zchap40/858D-/README.md

# 858E
(Otherwise known as the 858D++)
A new design for a hot air soldering station based on the original 858D+
