zchap40/858D-/PCB/v3.0/Images/858D++_v3.png

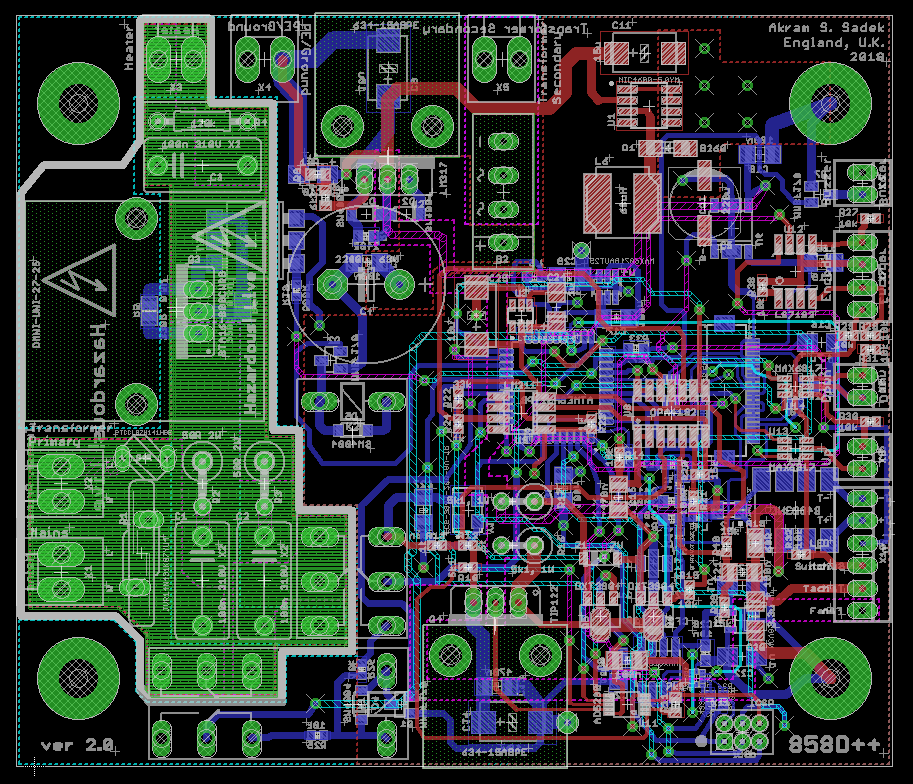
PCB/v3.0/Images/858D++_v3.png
