zchap40/858D-/PCB/v3.0/Images/v3_top.png

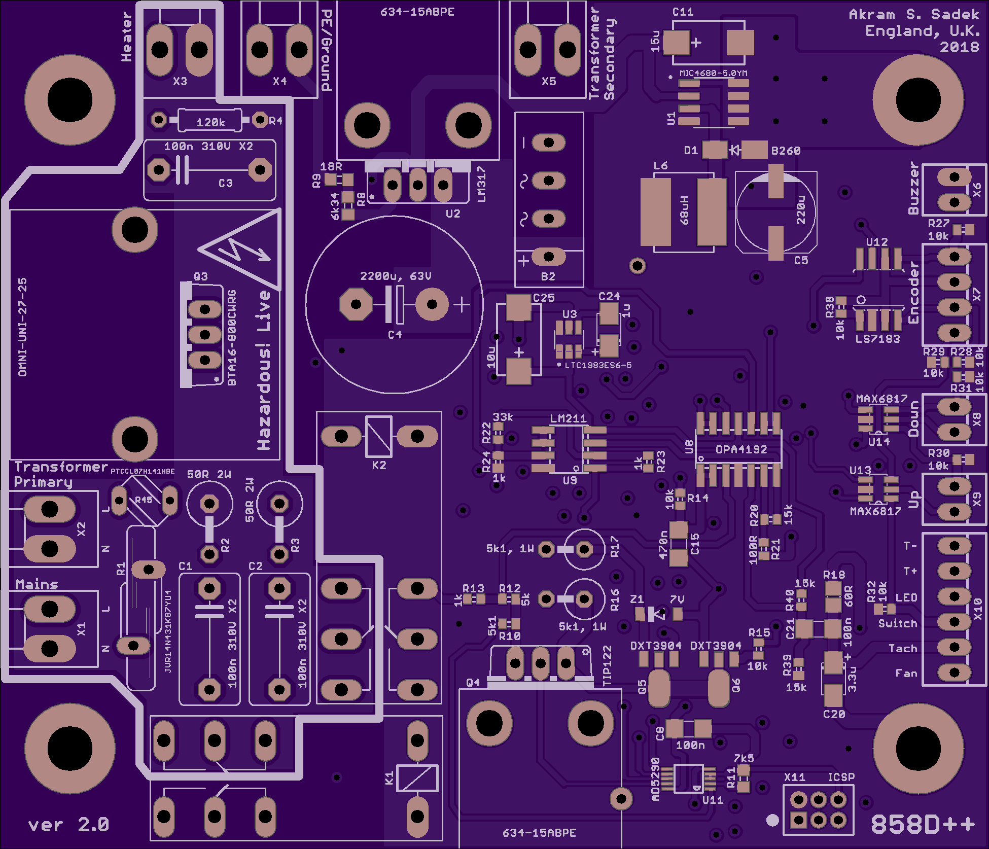
PCB/v3.0/Images/v3_top.png
