zchap40/858D-/BOM/_858D.xlsx

Sheet: ver 1.0
Quantity | Value | Parts | Description | Manufacturer Part Number | Manufacturer | Digi-Key Part Number | Farnell Part Number | Unit Price | Extended Price
1 |  |  | HEATSINK TO-247 TO-264 TO-220 | OMNI-UNI-27-25 | Wakefield-Vette | 345-1567-ND |  | 1.9 | £1.90
3 |  |  | HEATSINK SLIM VERT BLACK TO-220 | 634-15ABPE | Wakefield-Vette | 345-1129-ND |  | 1.41 | £4.23
1 | 24ppr |  | ROTARY ENCODER MECHANICAL 24PPR | PEC16-2215F-S0024 | Bourns Inc. | PEC16-2215F-S0024-ND |  | 1.23 | £1.23
2 | DPDT 8A 5V | K1, K2 | RELAY GENERAL PURPOSE DPDT 8A 5V | G2RL-2 DC5 | Omron Electronics Inc-EMC Div | Z3087-ND |  | 2.81 | £5.62
1 |  | X12 | CONN FFC TOP 24POS 0.50MM R/A | 524352471 | Molex, LLC | WM7975CT-ND |  | 1.91 | £1.91
1 |  |  | CONN MOD JACK 6P6C R/A, RJ-11 | MRJR-3360-01 | Amphenol Commercial Products | MRJR-3360-01-ND |  | 7.9 | £7.90
1 |  |  | CONN HEADER 6POS DL PCB 30GOLD | 69168-106HLF | Amphenol FCI | 609-2423-ND |  | 0.84 | £0.84
1 |  |  | CONN RECPT 6POS 2.54MM CRIMP | 69176-006LF | Amphenol FCI | 609-2380-ND |  | 1.21 | £1.21
6 |  |  | CONN SOCKET 22-26AWG CRIMP GOLD | 75231-013LF | Amphenol FCI | 609-4536-1-ND |  | 0.31 | £1.86
2 | 1000uF | C4, C5 | CAP ALUM 1000UF 20% 63V RADIAL | UHW1J102MHD | Nichicon | 493-14568-ND |  | 1.74 | £3.48
4 | 10uF | C9, C11, C14, C25 | CAP TANTALUM 10UF 63V 2917 | T521X106M063ATE050 | KEMET | 399-10461-1-ND |  | 4.61 | £18.44
1 | 4.7uF | C16 | CAP TANT POLY 4.7UF 35V 1411 | T521B475M035ATE150 | KEMET | 399-14256-1-ND |  | 0.92 | £0.92
1 | 3.3uF | C20 | CAP TANT POLY 3.3UF 35V 1411 |  | KEMET
4 | 1uF | C10, C22, C23, C24 | CAP TANT POLY 1UF 63V 1411 | T521B105M063ATE200 | KEMET | 399-14249-1-ND |  | 1.15 | £2.30
1 | 100nF | C1, C2, C3 | 100n 310V X2
2 | 470nF | C13, C15 | CAP CER 470nF 100V X7R 1206 | CGJ5L2X7R2A474K160AA | TDK Corporation | 445-9231-1-ND |  | 0.99 | £1.98
12 | 100nF |  | CAP CER 100nF 100V C0G 1206 | C3216C0G2A104J160AC | TDK Corporation | 445-172677-1-ND |  | 0.659 | £7.90
1 | 10nF |  | CAP CER 10nF 100V C0G 0603 | C1608C0G2A103J080AC | TDK Corporation | 445-172665-1-ND |  | 0.31 | £0.31
2 | 1uF |  | CAP CER 1uF 16V X7R 1210, X2Y | 160X41W105MV4E | Johanson Dielectrics Inc. | 709-1108-1-ND |  | 0.61 | £1.22
1 | 10nF |  | CAP CER 10nF 50V X7R 0603, X2Y | 500X14W103MV4T | Johanson Dielectrics Inc. | 709-1008-1-ND |  | 0.32 | £0.32
2 | 5k1 |  | RES 5.1K OHM 1W 1% AXIAL | H4P5K1FZA | TE Connectivity Passive Product | A129361-ND |  | 0.67 | £1.34
1 | 330R |  | RES SMD 330 OHM 1% 1/2W 0805 | CRCW0805330RFKEAHP | Vishay Dale | 541-330TCT-ND |  | 0.22 | £0.22
1 | 100R |  | RES 100 OHM 0.5% 1/5W 0402 | MCS0402PD1000DE500 | Vishay Beyschlag | 749-1509-1-ND |  | 0.49 | £0.49
1 | 330R |  | RES SMD 330 OHM 1% 1/5W 0402 | ERJ-PA2F3300X | Panasonic Electronic Components | P17221CT-ND |  | 0.18 | £0.18
1 | 499R |  | RES 499 OHM 0.5% 1/5W 0402 | MCS0402PD4990DE500 | Vishay Beyschlag | 749-1510-1-ND |  | 0.49 | £0.49
3 | 1k |  | RES 1K OHM 0.5% 1/5W 0402 | MCS0402PD1001DE500 | Vishay Beyschlag | 749-1511-1-ND |  | 0.49 | £1.47
1 | 1k69 |  | RES SMD 1.69K OHM 0.1% 1/5W 0603 | ERJ-PB3B1691V | Panasonic Electronic Components | P19996CT-ND |  | 0.2 | £0.20
1 | 240R |  | RES SMD 240 OHM 0.1% 1/5W 0603 | ERJ-PB3B2400V | Panasonic Electronic Components | P19899CT-ND |  | 0.2 | £0.20
1 | 18R |  | RES SMD 18 OHM 1% 1/4W 0603 | ERJ-PA3F18R0V | Panasonic Electronic Components | P18.00BYCT-ND |  | 0.13 | £0.13
1 | 6k34 |  | RES SMD 6.34K OHM 0.1% 1/5W 0603 | ERJ-PB3B6341V | Panasonic Electronic Components | P20064CT-ND |  | 0.2 | £0.20
3 | 4k99 |  | RES 4.99K OHM 0.5% 1/5W 0402 | MCS0402PD4991DE500 | Vishay Beyschlag | 749-1514-1-ND |  | 0.49 | £1.47
1 | 7k5 |  | RES SMD 7.5K OHM 0.1% 1/5W 0603 | ERJ-PB3B7501V | Panasonic Electronic Components | P20072CT-ND |  | 0.2 | £0.20
12 | 10k | R14, R15, R25, R26, R27, R28, R29, R30, R31, R32, R35, R38 | RES 10K OHM 0.5% 1/5W 0402 | MCS0402PD1002DE500 | Vishay Beyschlag | 749-1515-1-ND |  | 0.381 | £4.57
3 | 15k |  | RES 15K OHM 0.5% 1/5W 0402 | MCS0402PD1502DE500 | Vishay Beyschlag | 749-1516-1-ND |  | 0.49 | £1.47
1 | 33k |  | RES SMD 33K OHM 1% 1/5W 0402 | ERJ-PA2F3302X | Panasonic Electronic Components | P17233CT-ND |  | 0.18 | £0.18
1 | 412k |  | RES SMD 412K OHM 1% 1/10W 0603 | ERJ-3EKF4123V | Panasonic Electronic Components | P412KHCT-ND |  | 0.08 | £0.08
1 | 59R |  | RES SMD 59 OHM 1% 1/2W 0805 | ERJ-P06F59R0V | Panasonic Electronic Components | P16075CT-ND |  | 0.16 | £0.16
2 | 300R |  | RES SMD 300 OHM 0.1% 1/5W 0603 | ERJ-PB3B3000V | Panasonic Electronic Components | P19910CT-ND |  | 0.2 | £0.40
2 | 1M |  | RES SMD 1M OHM 1% 1/5W 0402 | ERJ-PA2F1004X | Panasonic Electronic Components | P17242CT-ND |  | 0.18 | £0.36
1 |  |  | CMC 260MA 2LN 600 OHM SMD | DLW31SN601SQ2L | Murata Electronics North America | 490-1068-1-ND |  | 0.96 | £0.96
2 |  |  | FERRITE BEAD 1 KOHM 0402 1LN | BLM15AX102SZ1D | Murata Electronics North America | 490-16654-1-ND |  | 0.09 | £0.18
1 | B4003 |  | COMMON MODE CHOKE 2LN SMD | B4003NLT | Pulse Electronics Network | 553-2143-1-ND |  | 3.19 | £3.19
1 | 10uH |  | INDUCTORPWR IND FOR DC/DC CONVER | L0603B100MDWFT | KEMET | 399-17788-1-ND |  | 0.32 | £0.32
2 | KBP310 |  | BRIDGE RECT 1PHASE 1KV 3A KBP | KBP310GTB | SMC Diode Solutions | 1655-1832-ND |  | 0.37 | £0.74
5 | SM4004 |  | DIODE GEN PURP 400V 1A SOD123FL | SM4004PL-TP | Micro Commercial Co | SM4004PL-TPMSCT-ND |  | 0.42 | £2.10
1 | PLZ7V5 |  | DIODE ZENER 7.035V 960MW DO219AC | PLZ7V5A-HG3/H | Vishay Semiconductor Diodes Division | PLZ7V5A-HG3/HGICT-ND |  | 0.26 | £0.26
3 | MMBF170 |  | MOSFET N-CH 60V 500MA SOT-23 | MMBF170LT1G | ON Semiconductor | MMBF170LT1GOSCT-ND |  | 0.28 | £0.84
2 | DXT3904 |  | TRANS NPN 40V 0.2A SOT89-3 | DXT3904-13 | Diodes Incorporated | DXT3904-13DICT-ND |  | 0.42 | £0.84
1 | TIP122 |  | TRANS NPN DARL 100V 5A TO220AB | TIP122G | ON Semiconductor | TIP122GOS-ND |  | 0.52 | £0.52
1 | BTA16-800 |  | TRIAC ALTERNISTOR 800V TO220AB | BTA16-800CWRG | STMicroelectronics | 497-4166-5-ND |  | 1.31 | £1.31
1 | LD1085V50 |  | IC REG LINEAR 5V 3A TO220AB | LD1085V50 | STMicroelectronics | 497-3436-5-ND |  | 1.02 | £1.02
1 | LM317 |  | IC REG LINEAR POS ADJ TO220-3 | LM317HVT/NOPB | Texas Instruments | LM317HVT/NOPB-ND |  | 1.93 | £1.93
1 | NCV8161-3.3V |  | IC REG LINEAR 3.3V 450MA 5TSOP | NCV8161ASN330T1G | ON Semiconductor | NCV8161ASN330T1GOSCT-ND |  | 0.45 | £0.45
1 | S1142-12.5V |  | IC REG LINEAR 12.5V 200MA 6HSOP | S-1142CC5I-E6T1U | ABLIC U.S.A. Inc. | 1662-2477-1-ND |  | 1.28 | £1.28
1 | LTC1983-5V |  | IC REG SWTCHD CAP INV -5V SOT23 | LTC1983ES6-5#TRPBF | Linear Technology/Analog Devices | LTC1983ES6-5#TRPBFCT-ND |  | 3.33 | £3.33
1 | ATMEGA324PB |  | IC MCU 8BIT 32KB FLASH 44TQFP | ATMEGA324PB-AN | Microchip Technology | ATMEGA324PB-AN-ND |  | 1.47 | £1.47
1 | LS7183 |  | Encoder to Counter Interface | LS7183N-S | LSI Computer Systems
1 | MAX31855 |  | IC CONV THERMOCOUPLE-DGTL SOIC | MAX31855KASA | Maxim Integrated | MAX31855KASA+-ND |  | 3.52
1 | AD5290 |  | DIGITAL POT 10K 256POS 10MSOP | AD5290YRMZ10 | Analog Devices | AD5290YRMZ10-ND |  | 4.3
2 | MAX6817 |  | IC DEBOUNCER SWITCH DUAL SOT23-6 | MAX6817EUT+T | Maxim Integrated | MAX6817EUT+TCT-ND |  | 4.1 | £8.20
1 | LM211 |  | IC DIFF COMPARATOR W/STRB 8-SOIC | LM211QDRQ1 | Texas Instruments | 296-17493-1-ND |  | 0.59 | £0.59
1 | OPA4192 | U8 | IC OPAMP RRI/O 14SOIC | OPA4192IDR | Texas Instruments | 296-43159-1-ND |  | 5.18 | £5.18
1 | MOC3062 |  | OPTOISOLATOR 4.17KV TRIAC 6SMD | MOC3062SR2VM | ON Semiconductor | MOC3062SR2VMCT-ND |  | 1.25 | £1.25
1 | 20.0000MHz | Y1 | XTAL OSC XO 20.0000MHZ HCMOS SMD | ECS-3961-200-AU-TR | ECS Inc. | XC1900CT-ND |  | 1.83 | £1.83

Sheet: ver 2.0
Qty | Value | Device | Package | Parts | Description | AVAILABILITY | DESCRIPTION | DIGI-KEY_PART_NUMBER | DIGI-KEY_PURCHASE_URL | MF | MP | MPN | OC_FARNELL | OC_NEWARK | PACKAGE | PRICE
3 | 22-23-2021 | 22-23-2021 | 22-23-2021 | X8, X9, X11 | .100 (2.54mm) Center Header - 2 Pin" |  |  |  |  | MOLEX |  | 22-23-2021 | 1462926 | 25C3832
1 | 22-23-2041 | 22-23-2041 | 22-23-2041 | X7 | .100 (2.54mm) Center Header - 4 Pin" |  |  |  |  | MOLEX |  | 22-23-2041 | 1462920 | 38C0355
1 |  | 22-23-2061 | 22-23-2061 | X10 | .100 (2.54mm) Center Header - 6 Pin" |  |  |  |  | MOLEX |  | 22-23-2061 | 1462922 | 27C1933
4 |  | KK-156-2 | KK-156-2 | X1, X2, X3, X4 | KK 156 HEADER |  |  |  |  |  |  |  | unknown | unknown
1 |  | KK-156-4 | KK-156-4 | X5 | KK 156 HEADER |  |  |  |  |  |  |  | unknown | unknown
2 | 1000uF, 63V | CPOL-EUE5-13 | E5-13 | C4, C5 | POLARIZED CAPACITOR, European symbol
4 | 10u | CPOL-USCT7343 | CT7343 | C9, C11, C14, C25 | POLARIZED CAPACITOR, American symbol
1 | 4.7u | CPOL-USB/3528-21W | B/3528-21W | C16 | POLARIZED CAPACITOR, American symbol
1 | 3.3u | CPOL-USB/3528-21W | B/3528-21W | C20 | POLARIZED CAPACITOR, American symbol
4 | 1u | CPOL-USB/3528-21W | B/3528-21W | C10, C22, C23, C24 | POLARIZED CAPACITOR, American symbol
2 | 470n | C-EUC1206 | C1206 | C13, C15 | CAPACITOR, European symbol
3 | 100n 310V X2 | C10/6 | C10B6 | C1, C2, C3 | CAPACITOR
12 | 100n | C-EUC1206 | C1206 | C6, C7, C8, C12, C17, C18, C19, C21, C26, C27, C29, C30 | CAPACITOR, European symbol
1 | 10n | C-EUC0603 | C0603 | C28 | CAPACITOR, European symbol
2 | 1u | X2Y1206 | C1206-X2Y | CF1, CF2
1 | 10n | X2Y0603 | C0603-X2Y | CF3
1 | 10uH | KLZ1608MHR100WTD25 | INDC1608X95N | L5 | FIXED IND 10UH 250MA 1.365 OHM | Unavailable | Inductor Decoupling Circuit Shielded Multi-Layer 10uH 20% 2MHz Ferrite 250mA 1.365Ohm DCR 0603 Automotive T/R |  |  | TDK | KLZ1608MHR100WTD25 |  |  |  | 0603 TDK | None
1 | B4003NL | B4003NL | SMD-VERTICAL | L1 | Pulse Electronics
2 | BLM15AX102SZ1D | BLM15HB121SN1 | 402 | L3, L4 | EMIFIL (R) Chip Ferrite Bead for GHz Noise
1 | DLW31SN601SQ2L | DLW31SN900SQ2L | FIL_DLW31SN900SQ2L | L2 | Common Mode Chokes Dual 90Ohm 100MHz 370mA 300mOhm DCR SMD Embossed T/R |  | Common Mode Chokes Dual 90Ohm 100MHz 370mA 300mOhm DCR SMD Embossed T/R | 490-1067-1-ND | https://www.digikey.com/product-detail/en/murata-electronics-north-america/DLW31SN900SQ2L/490-1067-1-ND/584513 | Murata Electronics | DLW31SN900SQ2L |  |  |  | Horizontal-4 Murata Electronics
1 | 100R | R-EU_R0402 | R0402 | R21 | RESISTOR, European symbol
1 | 120k | R-EU_0207/10 | 0207/10 | R4 | RESISTOR, European symbol
12 | 10k | R-EU_R0402 | R0402 | R14, R15, R25, R26, R27, R28, R29, R30, R31, R32, R35, R38 | RESISTOR, European symbol
3 | 15k | R-EU_R0402 | R0402 | R20, R39, R40 | RESISTOR, European symbol
1 | 18R | R-EU_R0603 | R0603 | R9 | RESISTOR, European symbol
2 | 1M | R-EU_R0402 | R0402 | R43, R44 | RESISTOR, European symbol
3 | 1k | R-EU_R0402 | R0402 | R13, R23, R24 | RESISTOR, European symbol
1 | 1k7 | R-EU_R0603 | R0603 | R33 | RESISTOR, European symbol
1 | 240R | R-EU_R0603 | R0603 | R7 | RESISTOR, European symbol
2 | 300R, 0.1% | R-EU_R0603 | R0603 | R41, R42 | RESISTOR, European symbol
2 | 330R | R-EU_R0402 | R0402 | R36, R37 | RESISTOR, European symbol
2 | 330R, 0.5W | R-EU_R0805 | R0805 | R5, R6 | RESISTOR, European symbol
1 | 33k | R-EU_R0402 | R0402 | R22 | RESISTOR, European symbol
1 | 412k | R-EU_R0603 | R0603 | R34 | RESISTOR, European symbol
1 | 500R | R-EU_R0402 | R0402 | R19 | RESISTOR, European symbol
2 | 50R 2W | R-EU_0613/5V | P0613V | R2, R3 | RESISTOR, European symbol
1 | 5k | R-EU_R0402 | R0402 | R12 | RESISTOR, European symbol
1 | 5k1 | R-EU_R0402 | R0402 | R10 | RESISTOR, European symbol
2 | 5k1, 1W | R-EU_0411/3V | 0411V | R16, R17 | RESISTOR, European symbol
1 | 60R | R-EU_R0805 | R0805 | R18 | RESISTOR, European symbol
1 | 6k34 | R-EU_R0603 | R0603 | R8 | RESISTOR, European symbol
1 | 7V | ZENER-DIODEDO-219AC | MICROSMF | Z1 | Z-Diode
1 | 7k5 | R-EU_R0603 | R0603 | R11 | RESISTOR, European symbol
1 | 87758-06_S | 87758-06_S | 87758-06 | X12 | HEADER
1 | AD5290 | AD5290 | MSOP10 | U11 | Compact +30 V / ±15 V 256-Position Digital Potentiometer
1 | ATMEGA324PB | ATMEGA324PB-ANR | QFP80P1200X1200X120-44N | U15 | None | Unavailable | 20mhz, Tqfp, Extended Temp, Green 5 v t&r |  |  | Microchip | ATMEGA324PB-ANR |  |  |  | TQFP-44 Microchip | None
1 | BTA16-800CWRG | BT138-V | TO220BV | Q3 | TRIAC
2 | DXT3904 | DXT3904 | SOT89-BCE | Q5, Q6 | Diodes Incorporated
1 | ECS-3961-200-AU-TR | ECS-3961-200-AU-TR | OSC_ECS-3961-200-AU-TR | Y1 | miniature SMD crystal controlled oscillators |  | Clock Oscillator 20MHz 5V 30pF 4-Pin SMD T/R | XC1900CT-ND | https://www.digikey.co.uk/product-detail/en/ecs-inc/ECS-3961-200-AU-TR/XC1900CT-ND/2782025 | ECS Inc. | ECS-3961-200-AU-TR |  |  |  | SMD-4 ECS International
1 | FH12-24S-0.5SH | FH12-24S-0.5SH | FH12-24S-0.5SH | X6 | 0.5mm Pitch Connectors For FPC/FFC |  |  |  |  |  |  | FH12-24S-0.5SH(55) | 1324552 | 34M6170
1 | JVR14N431K87YU4 | S14K11 | S14K11 | R1 | VARISTOR
2 | KBP310GTB | RECTIFIER-2KBP | 2KBP | B1, B2 | Rectifier
1 | LD1085V50 | 7805TV | TO220V | U1 | Positive VOLTAGE REGULATOR
1 | LM211 | LM311D | SO08 | U9 | COMPARATOR
1 | LM317 | LM317TS | 317TS | U2 | VOLTAGE REGULATOR
1 | LS7183 | LS7183-SOIC | SOIC08 | U12 | Encoder to Counter Interface | Unavailable | Semi-Linear-Cmos Power Source |  |  | LSI | LS7183 |  |  |  | None | None
1 | LTC1983ES6-5 | LTC1983ES6-5#TRPBF | SOT95P280X100-6N | U3 | Charge Pump INV -5V/-2.3V to -5.5V 100mA 6-Pin TSOT-23 T/R |  | Charge Pump INV -5V/-2.3V to -5.5V 100mA 6-Pin TSOT-23 T/R | LTC1983ES6-5#TRPBFCT-ND | https://www.digikey.co.uk/product-detail/en/linear-technology-analog-devices/LTC1983ES6-5-TRPBF/LTC1983ES6-5-TRPBFCT-ND/7897923 | Linear Technology/Analog | LTC1983ES6-5#TRPBF |  |  |  | SOT-23-6 Analog Devices / Linear Technology
1 | MAX31855 | MAX31855 | SOIC127P600X175-8N | U7 | Cold-Junction Compensated Thermocouple-to-Digital Converter | Unavailable |  |  |  | Maxim Integrated | MAX31855 |  |  |  | SO-8 Maxim Integrated | None
1 | MAX6071BAUT25T | MAX6071BAUT25T | 21-0058I | U4 |  |  | V-Ref Precision 2.5V 10mA 6-Pin SOT-23 T/R | MAX6071BAUT25+TCT-ND | https://www.digikey.co.uk/product-detail/en/maxim-integrated/MAX6071BAUT25-T/MAX6071BAUT25-TCT-ND/5051522 | Maxim Integrated | MAX6071BAUT25+T |  |  |  | SOT-23-6 Maxim Integrated
2 | MAX6817 | MAX6817EUT+T | SOT95P280X145-6N | U13, U14 | ±15kV ESD-Protected CMOS Switch Debouncers |  | Ic Debouncer Switch Dual Sot23-6 - Max6817eut+t | MAX6817EUT+TCT-ND | https://www.digikey.co.uk/product-detail/en/maxim-integrated/MAX6817EUT-T/MAX6817EUT-TCT-ND/774156 | Maxim Integrated | MAX6817EUT+T |  |  |  | SOT-23-6 Maxim Integrated
3 | MMBF170 | MMBF170LT1G | SOT23 | Q1, Q2, Q7 | Power MOSFET
1 | MOC3062SR2VM | MOC3041S | DIL6-SMD | U10 | 6-Pin DIP Zero-Cross Optoisolators Triac Driver Output (250/400 Volt Peak) |  |  |  |  | FAIRCHILD SEMICONDUCTOR |  | MOC3041S-M | unknown | 05C2885
1 | NCV8161-3.3V | NCV8161ASN330T1G | SOT23-DBV | U5 | ON Semiconductor
1 | OPA4192 | OP11D | SO14 | U8 | Quad Low-Offset Low-Power OP AMP
1 | S-1142DC5I | S-1142CC5I-E6T1U | HSOP-6 | U6 | HIGH-WITHSTAND VOLTAGE LOW CURRENT CONSUMPTION LOW DROPOUT
5 | SM4004 | SM4004 | SOD123FL | D1, D2, D3, D4, D5 | 1.0 Ampere Silion Rectifier 400V SMD
1 | TIP122 | TIP122-V | TO220V | Q4
2 | 4052 | 4052 | F4052 | K1, K2 | RELAY |  |  |  |  |  |  |  | unknown | unknown
3 | 634-15ABPE | 634-15ABPE | 634-15ABPE | HS1, HS2, HS4 | Wakefield-Vette 634-15-ABPE
1 | OMNI-UNI-27-25 | OMNI-UNI-27-25 | OMNI-UNI-27-25 | HS3

Sheet: Bom_7735623
Manufacturer Part Number | Manufacturer | Digi-Key Part Number | Customer Reference | Quantity | Unit Price | Extended Price | Description
OMNI-UNI-27-25 | Wakefield-Vette | 345-1567-ND |  | 1 | 1.9 | £1.90 | HEATSINK TO-247 TO-264 TO-220
G2RL-2 DC5 | Omron Electronics Inc-EMC Div | Z3087-ND |  | 2 | 2.81 | £5.62 | RELAY GENERAL PURPOSE DPDT 8A 5V
524352471 | Molex, LLC | WM7975CT-ND |  | 1 | 1.91 | £1.91 | CONN FFC TOP 24POS 0.50MM R/A
KBP310GTB | SMC Diode Solutions | 1655-1832-ND |  | 2 | 0.37 | £0.74 | BRIDGE RECT 1PHASE 1KV 3A KBP
S-1142CC5I-E6T1U | ABLIC U.S.A. Inc. | 1662-2477-1-ND |  | 1 | 1.28 | £1.28 | IC REG LINEAR 12.5V 200MA 6HSOP
LTC1983ES6-5#TRPBF | Linear Technology/Analog Devices | LTC1983ES6-5#TRPBFCT-ND |  | 1 | 3.33 | £3.33 | IC REG SWTCHD CAP INV -5V SOT23
SM4004PL-TP | Micro Commercial Co | SM4004PL-TPMSCT-ND |  | 4 | 0.42 | £1.68 | DIODE GEN PURP 400V 1A SOD123FL
MMBF170LT1G | ON Semiconductor | MMBF170LT1GOSCT-ND |  | 3 | 0.28 | £0.84 | MOSFET N-CH 60V 500MA SOT-23
634-15ABPE | Wakefield-Vette | 345-1129-ND |  | 2 | 1.41 | £2.82 | HEATSINK SLIM VERT BLACK TO-220
DXT3904-13 | Diodes Incorporated | DXT3904-13DICT-ND |  | 2 | 0.42 | £0.84 | TRANS NPN 40V 0.2A SOT89-3
LM317HVT/NOPB | Texas Instruments | LM317HVT/NOPB-ND |  | 1 | 1.93 | £1.93 | IC REG LINEAR POS ADJ TO220-3
T521X106M063ATE050 | KEMET | 399-10461-1-ND |  | 3 | 4.61 | £13.83 | CAP TANTALUM 10UF 63V 2917
T521B105M063ATE200 | KEMET | 399-14249-1-ND |  | 4 | 1.15 | £4.60 | CAP TANT POLY 1UF 63V 1411
CGJ5L2X7R2A474K160AA | TDK Corporation | 445-9231-1-ND |  | 2 | 0.99 | £1.98 | CAP CER 0.47UF 100V X7R 1206
PLZ7V5A-HG3/H | Vishay Semiconductor Diodes Division | PLZ7V5A-HG3/HGICT-ND |  | 1 | 0.26 | £0.26 | DIODE ZENER 7.035V 960MW DO219AC
H4P5K1FZA | TE Connectivity Passive Product | A129361-ND |  | 2 | 0.67 | £1.34 | RES 5.1K OHM 1W 1% AXIAL
PEC16-2215F-S0024 | Bourns Inc. | PEC16-2215F-S0024-ND |  | 1 | 1.23 | £1.23 | ROTARY ENCODER MECHANICAL 24PPR
NCV8161ASN330T1G | ON Semiconductor | NCV8161ASN330T1GOSCT-ND |  | 1 | 0.45 | £0.45 | IC REG LINEAR 3.3V 450MA 5TSOP
ATMEGA324PB-AN | Microchip Technology | ATMEGA324PB-AN-ND |  | 1 | 1.47 | £1.47 | IC MCU 8BIT 32KB FLASH 44TQFP
LM211QDRQ1 | Texas Instruments | 296-17493-1-ND |  | 1 | 0.59 | £0.59 | IC DIFF COMPARATOR W/STRB 8-SOIC
ECS-3961-200-AU-TR | ECS Inc. | XC1900CT-ND |  | 1 | 1.83 | £1.83 | XTAL OSC XO 20.0000MHZ HCMOS SMD
MAX6817EUT+T | Maxim Integrated | MAX6817EUT+TCT-ND |  | 2 | 4.1 | £8.20 | IC DEBOUNCER SWITCH DUAL SOT23-6
TIP122G | ON Semiconductor | TIP122GOS-ND |  | 1 | 0.52 | £0.52 | TRANS NPN DARL 100V 5A TO220AB
T521B475M035ATE150 | KEMET | 399-14256-1-ND |  | 1 | 0.92 | £0.92 | CAP TANT POLY 4.7UF 35V 1411
MRJR-3360-01 | Amphenol ICC (Commercial Products) | MRJR-3360-01-ND |  | 1 | 7.9 | £7.90 | CONN MOD JACK 6P6C R/A
69168-106HLF | Amphenol ICC (FCI) | 609-2423-ND |  | 1 | 0.84 | £0.84 | CONN HEADER VERT 6POS 2.54MM
75231-013LF | Amphenol ICC (FCI) | 609-4536-1-ND |  | 6 | 0.31 | £1.86 | CONN SOCKET 22-26AWG CRIMP GOLD
69176-006LF | Amphenol ICC (FCI) | 609-2380-ND |  | 1 | 1.21 | £1.21 | CONN RECPT 6POS 2.54MM CRIMP
MOC3062SR2VM | ON Semiconductor | MOC3062SR2VMCT-ND |  | 1 | 1.25 | £1.25 | OPTOISOLATOR 4.17KV TRIAC 6SMD
BTA16-800CWRG | STMicroelectronics | 497-4166-5-ND |  | 1 | 1.31 | £1.31 | TRIAC ALTERNISTOR 800V TO220AB
OPA4192IDR | Texas Instruments | 296-43159-1-ND |  | 1 | 5.18 | £5.18 | IC OPAMP RRI/O 14SOIC
CRCW0805330RFKEAHP | Vishay Dale | 541-330TCT-ND |  | 1 | 0.22 | £0.22 | RES SMD 330 OHM 1% 1/2W 0805
MCS0402PD1000DE500 | Vishay Beyschlag | 749-1509-1-ND |  | 1 | 0.49 | £0.49 | RES 100 OHM 0.5% 1/5W 0402
ERJ-PA2F3300X | Panasonic Electronic Components | P17221CT-ND |  | 1 | 0.18 | £0.18 | RES SMD 330 OHM 1% 1/5W 0402
MCS0402PD4990DE500 | Vishay Beyschlag | 749-1510-1-ND |  | 1 | 0.49 | £0.49 | RES 499 OHM 0.5% 1/5W 0402
MCS0402PD1001DE500 | Vishay Beyschlag | 749-1511-1-ND |  | 3 | 0.49 | £1.47 | RES 1K OHM 0.5% 1/5W 0402
ERJ-PB3B1691V | Panasonic Electronic Components | P19996CT-ND |  | 1 | 0.2 | £0.20 | RES SMD 1.69K OHM 0.1% 1/5W 0603
ERJ-PB3B2400V | Panasonic Electronic Components | P19899CT-ND |  | 1 | 0.2 | £0.20 | RES SMD 240 OHM 0.1% 1/5W 0603
ERJ-PA3F18R0V | Panasonic Electronic Components | P18.00BYCT-ND |  | 1 | 0.13 | £0.13 | RES SMD 18 OHM 1% 1/4W 0603
ERJ-PB3B6341V | Panasonic Electronic Components | P20064CT-ND |  | 1 | 0.2 | £0.20 | RES SMD 6.34K OHM 0.1% 1/5W 0603
MCS0402PD4991DE500 | Vishay Beyschlag | 749-1514-1-ND |  | 3 | 0.49 | £1.47 | RES 4.99K OHM 0.5% 1/5W 0402
ERJ-PB3B7501V | Panasonic Electronic Components | P20072CT-ND |  | 1 | 0.2 | £0.20 | RES SMD 7.5K OHM 0.1% 1/5W 0603
MCS0402PD1002DE500 | Vishay Beyschlag | 749-1515-1-ND |  | 20 | 0.381 | £7.62 | RES 10K OHM 0.5% 1/5W 0402
MCS0402PD1502DE500 | Vishay Beyschlag | 749-1516-1-ND |  | 3 | 0.49 | £1.47 | RES 15K OHM 0.5% 1/5W 0402
ERJ-PA2F3302X | Panasonic Electronic Components | P17233CT-ND |  | 1 | 0.18 | £0.18 | RES SMD 33K OHM 1% 1/5W 0402
ERJ-3EKF4123V | Panasonic Electronic Components | P412KHCT-ND |  | 1 | 0.08 | £0.08 | RES SMD 412K OHM 1% 1/10W 0603
ERJ-P06F59R0V | Panasonic Electronic Components | P16075CT-ND |  | 1 | 0.16 | £0.16 | RES SMD 59 OHM 1% 1/2W 0805
500X14W103MV4T | Johanson Dielectrics Inc. | 709-1008-1-ND |  | 1 | 0.32 | £0.32 | CAP CER 10000PF 50V X7R 0603
160X41W105MV4E | Johanson Dielectrics Inc. | 709-1108-1-ND |  | 2 | 0.61 | £1.22 | CAP CER 1UF 16V X7R 1210
DLW31SN601SQ2L | Murata Electronics North America | 490-1068-1-ND |  | 1 | 0.96 | £0.96 | CMC 260MA 2LN 600 OHM SMD
BLM15AX102SZ1D | Murata Electronics North America | 490-16654-1-ND |  | 2 | 0.09 | £0.18 | FERRITE BEAD 1 KOHM 0402 1LN
B4003NLT | Pulse Electronics Network | 553-2143-1-ND |  | 1 | 3.19 | £3.19 | COMMON MODE CHOKE 2LN SMD
ERJ-PB3B3000V | Panasonic Electronic Components | P19910CT-ND |  | 2 | 0.2 | £0.40 | RES SMD 300 OHM 0.1% 1/5W 0603
ERJ-PA2F1004X | Panasonic Electronic Components | P17242CT-ND |  | 2 | 0.18 | £0.36 | RES SMD 1M OHM 1% 1/5W 0402
C3216C0G2A104J160AC | TDK Corporation | 445-172677-1-ND |  | 12 | 0.659 | £7.90 | CAP CER 0.1UF 100V C0G 1206
C1608C0G2A103J080AC | TDK Corporation | 445-172665-1-ND |  | 1 | 0.31 | £0.31 | CAP CER 10000PF 100V C0G 0603
L0603B100MDWFT | KEMET | 399-17788-1-ND |  | 1 | 0.32 | £0.32 | INDUCTORPWR IND FOR DC/DC CONVER
MAX31855KASA+ | Maxim Integrated | MAX31855KASA+-ND |  | 1 | 3.52 | £3.52 | IC CONV THERMOCOUPLE-DGTL SOIC
AD5290YRMZ10 | Analog Devices Inc. | AD5290YRMZ10-ND |  | 1 | 4.3 | £4.30 | IC DGTL POT 10K 256POS 10MSOP
PTCCL07H141HBE | Vishay BC Components | BC2719-ND |  | 1 | 1.01 | £1.01 | PTC RESET FUSE 265V 140MA RADIAL
TXB0104QRUTRQ1 | Texas Instruments | 296-41033-1-ND |  | 1 | 1.17 | £1.17 | IC TRNSLTR BIDIRECTIONAL 12UQFN
TXB0102DCUR | Texas Instruments | 296-22862-1-ND |  | 1 | 0.72 | £0.72 | IC TRNSLTR BIDIRECTIONAL US8
MIC4680-5.0YM | Microchip Technology | 576-3379-5-ND |  | 1 | 1.77 | £1.77 | IC REG BUCK BOOST 5V 1.3A 8SOIC
UHW1J222MHD | Nichicon | 493-14574-ND |  | 1 | 3.16 | £3.16 | CAP ALUM 2200UF 20% 63V RADIAL
T521X156M063ATE035 | KEMET | 399-10460-1-ND |  | 1 | 5.07 | £5.07 | CAP TANTALUM 15UF 63V 2917
B260AQ-13-F | Diodes Incorporated | B260AQ-13-FDICT-ND |  | 1 | 0.32 | £0.32 | DIODE SCHOTTKY 60V 2A SMA
SRN8040TA-680M | Bourns Inc. | SRN8040TA-680MCT-ND |  | 1 | 0.58 | £0.58 | FIXED IND 68UH 1.65A 205 MOHM
UWD1E221MCL1GS | Nichicon | 493-6291-1-ND |  | 1 | 0.71 | £0.71 | CAP ALUM 220UF 20% 25V SMD
S202121SS03Q | C&K | CKN10659-ND |  | 1 | 3.17 | £3.17 | SWITCH SLIDE DPDT 6A 125V

Sheet: Sheet4
Knob, Round Shaft, 6.35 mm, Aluminium, Round with Top Indicator Line, 25 mm (https://uk.farnell.com/webapp/wcs/stores/servlet/ProductDisplay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) | 1439981 | 1 | MULTICOMP | 25T-2T | 3.67
Through Hole Resistor, 120 kohm, VR25 Series, 250 mW, ± 1%, Axial Leaded, 1.6 kV (https://uk.farnell.com/webapp/wcs/stores/servlet/ProductDisplay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) | 2056504 | 1 | VISHAY | VR25000001203FA500 | 0.189
Through Hole Resistor, 51 ohm, MCKNP Series, 2 W, ± 5%, Axial Leaded (https://uk.farnell.com/webapp/wcs/stores/servlet/ProductDisplay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) | 1903786 | 2 | MULTICOMP | MCKNP02SJ0510A10 | 0.145
Graphic OLED, 128 x 64, White on Black, 2.8V, I2C, Parallel, SPI, 42mm x 27.2mm, -40 °C (https://uk.farnell.com/webapp/wcs/stores/servlet/ProductDisplay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) | 2342676 | 1 | MIDAS | MCOT128064BY-WM | 29.39
Transducer, 3 V to 28 V, Continuous, 90 dB, Sounder, 5 mA, Panel Mount (https://uk.farnell.com/webapp/wcs/stores/servlet/ProductDisplay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) | 1653528 | 1 | PROJECTS UNLIMITED | AI-3245-TF-LW95-R | 3.19
Toroidal Transformer, 31mm x 70mm, 30 VA, 2 x 12V, Chassis, 2 x 115V (https://uk.farnell.com/webapp/wcs/stores/servlet/ProductDisplay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) | 2362145 | 1 | BLOCK | RKD 30/2X12 | 25.74
