zchap40/858D-/CAD/858D++.stl

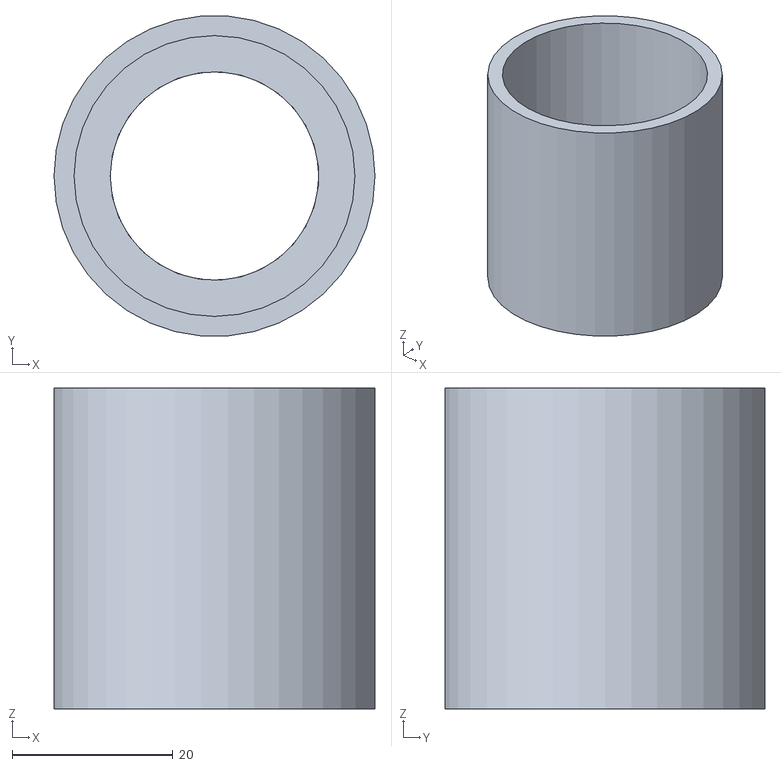
[picture p4: CAD file, 2022-09-27]
CAD/858D++.stl
40.0 x 39.9 x 40.0
