zchap40/858D-/(list of files, cad)

Other CAD files:
CAD/858D++_v2.dwg
CAD/858D++.dwg
