zchap40/858D-/Schematics/858D++_v2.pdf

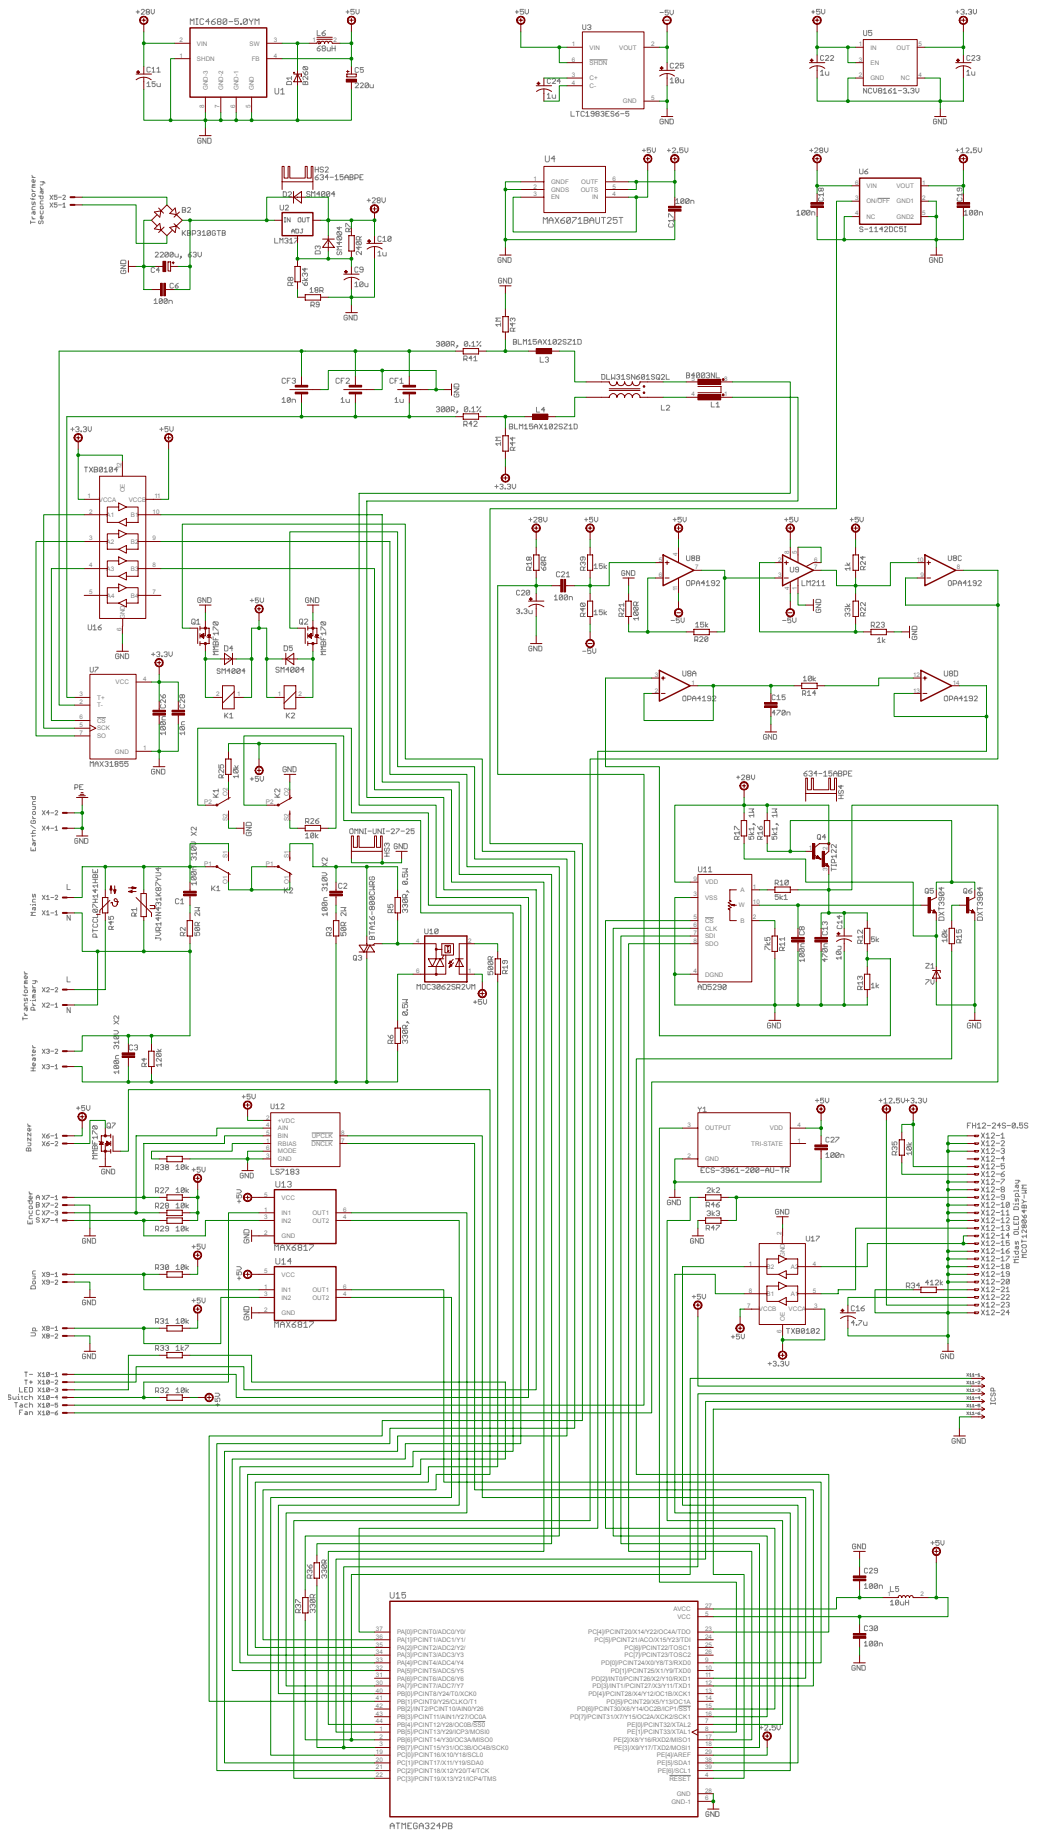
[picture p5: page 1]
VDD 9; VSS 3; DGND 4; CLK 6 SDI 7 SDO 8; VCC; GND; SCK 5; VIN 1; VOUT; SHDN 6; VIN 6; ON/OFF 3; GND2 5; VOUT 1; GND1 2; OUT; GND 2; TRI-STATE; VDD; 4 OUTPUT 3; VCC 5; OUT1; OUT2; GNDF 1 GNDS 2; 4 OUTS; 5 OUTF; RBIAS 1; +VDC 2; GND 3; AIN 4 BIN 5; MODE 6; UPCLK 8 DNCLK 7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
