zchap40/858D-/PCB/v3.0/858D_v3.brd

## EAGLE design PCB/v3.0/858D_v3.brd (2022-09-27)

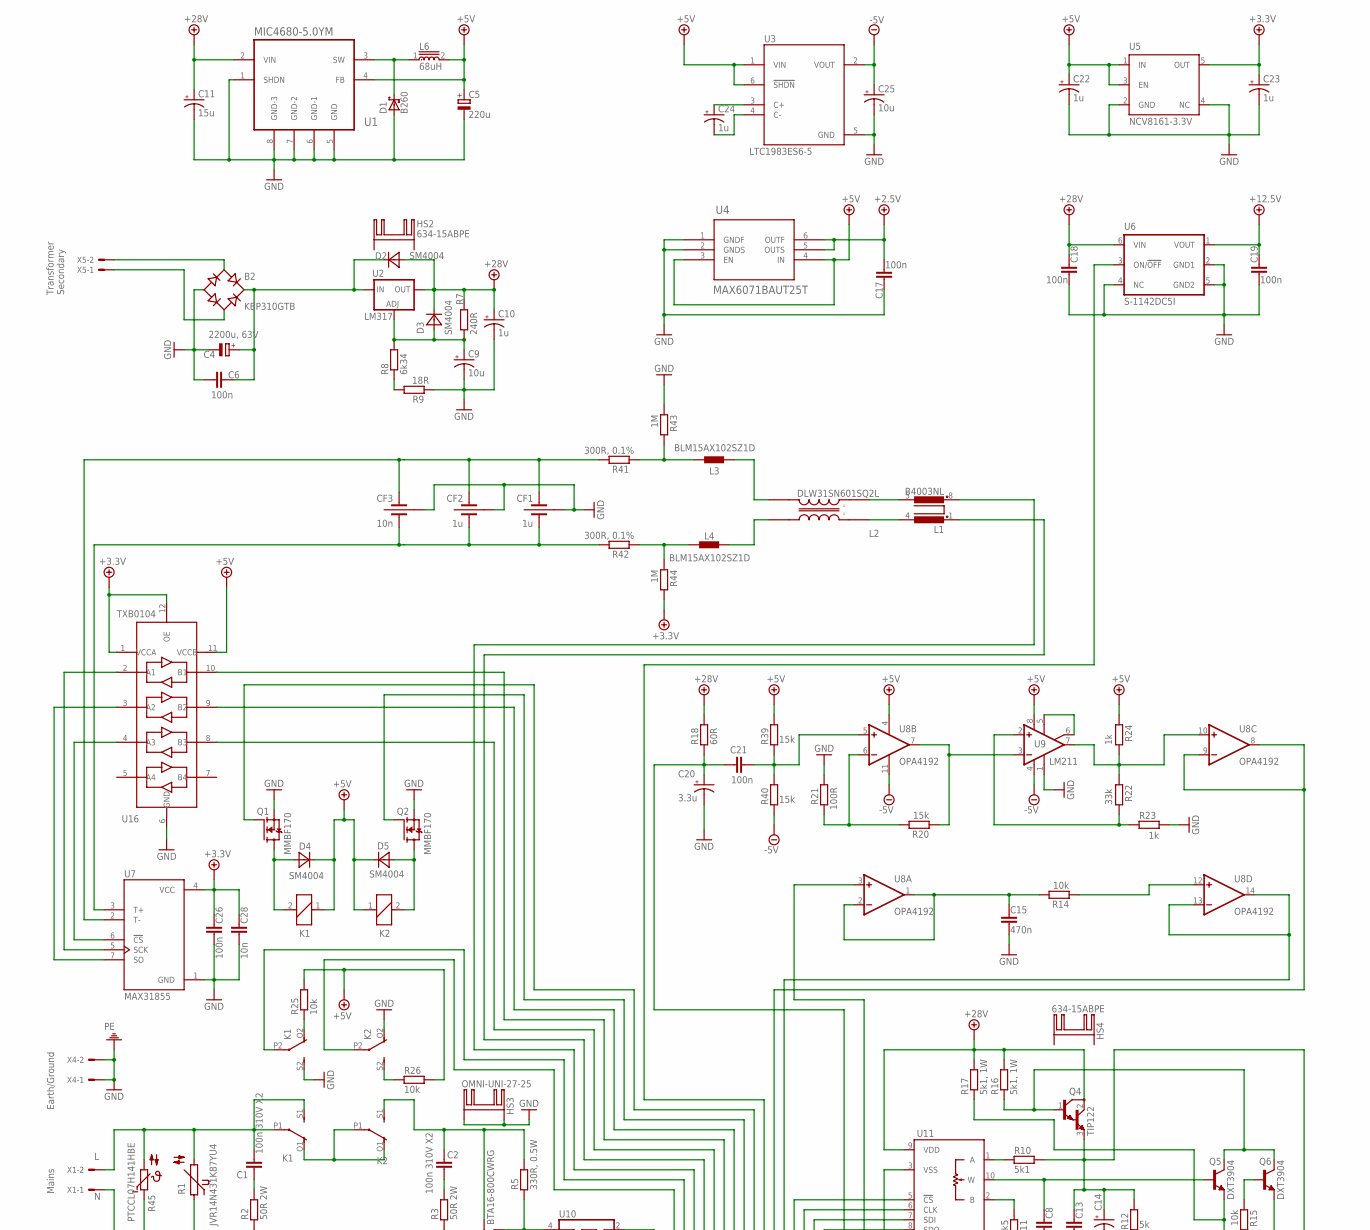
[picture p6: schematic 858D_v3.sch, part in row 1, column 1]

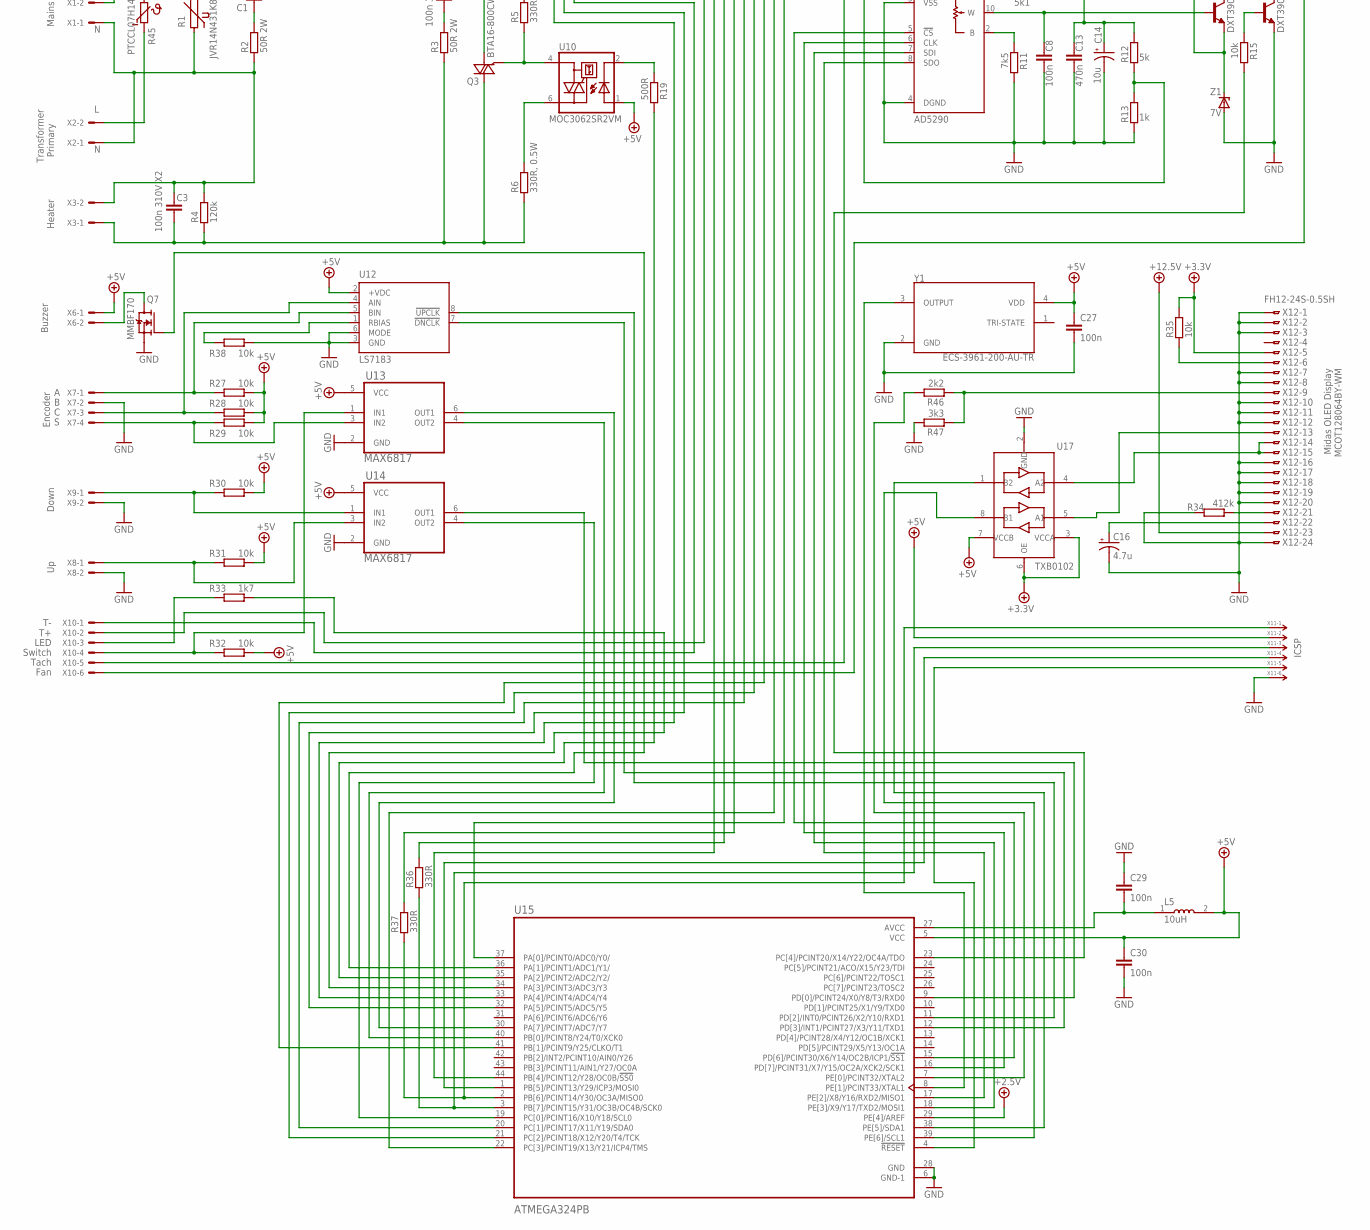
[picture p7: schematic 858D_v3.sch, part in row 2, column 1]

Parts:
B2: KBP310GTB; 2KBP
C1, C2, C3: 100n 310V X2; C10B6
C4: 2200u, 63V; E7,5-18
C5: 220u; UD-8X10_NICHICON
C6, C8, C17, C18, C19, C21, C26, C27, C29, C30: 100n; C1206
C9, C14, C25: 10u; CT7343
C10, C22, C23, C24: 1u; B/3528-21W
C11: 15u; CT7343
C13, C15: 470n; C1206
C16: 4.7u; B/3528-21W
C20: 3.3u; B/3528-21W
C28: 10n; C0603
CF1, CF2: 1u; C1206-X2Y
CF3: 10n; C0603-X2Y
D1: B260; SMA-DO214AC_2
D2, D3, D4, D5: SM4004; SOD123FL
HS2, HS4: 634-15ABPE
HS3: OMNI-UNI-27-25
K1, K2: 4052; F4052
L1: B4003NL; SMD-VERTICAL
L2: DLW31SN601SQ2L; FIL_DLW31SN900SQ2L
L3, L4: BLM15AX102SZ1D; 0402
L5: 10uH; INDC1608X95N
L6: 68uH; SRN8040
Q1, Q2, Q7: MMBF170; SOT23
Q3: BTA16-800CWRG; TO220BV
Q4: TIP122; TO220V
Q5, Q6: DXT3904; SOT89-BCE
R1: JVR14N431K87YU4; S14K11
R2, R3: 50R 2W; P0613V
R4: 120k; 0207/10
R5, R6: 330R, 0.5W; R0805
R7: 240R; R0603
R8: 6k34; R0603
R9: 18R; R0603
R10: 5k1; R0402
R11: 7k5; R0603
R12: 5k; R0402
R13, R23, R24: 1k; R0402
R14, R15, R25, R26, R27, R28, R29, R30, R31, R32, R35, R38: 10k; R0402
R16, R17: 5k1, 1W; 0411V
R18: 60R; R0805
R19: 500R; R0402
R20, R39, R40: 15k; R0402
R21: 100R; R0402
R22: 33k; R0402
R33: 1k7; R0603
R34: 412k; R0603
R36, R37: 330R; R0402
R41, R42: 300R, 0.1%; R0603
R43, R44: 1M; R0402
R45: PTCCL07H141HBE; B57164
R46: 2k2; R0402
R47: 3k3; R0402
U1: MIC4680-5.0YM; SOIC127P600X175-8N
U2: LM317; 317TS
U3: LTC1983ES6-5; SOT95P280X100-6N
U4: MAX6071BAUT25T; 21-0058I
U5: NCV8161-3.3V; SOT23-DBV
U6: S-1142DC5I; HSOP-6
U7: MAX31855; SOIC127P600X175-8N
U8: OPA4192; SO14
U9: LM211; SO08
U10: MOC3062SR2VM; DIL6-SMD
U11: AD5290; MSOP10
U12: LS7183; SOIC08
U13, U14: MAX6817; SOT95P280X145-6N
U15: ATMEGA324PB; QFP80P1200X1200X120-44N
U16: TXB0104; QFN40P170X200X50-12N
U17: TXB0102; 8-VFSOP
X1, X2, X3, X4, X5: KK-156-2
X6, X8, X9: 22-23-2021
X7: 22-23-2041
X10: 22-23-2061
X11: 87758-06_S; 87758-06
X12: FH12-24S-0.5SH
Y1: ECS-3961-200-AU-TR; OSC_ECS-3961-200-AU-TR
Z1: 7V; MICROSMF

Connections:
28AC1: B2.AC2, X5.1
28AC2: B2.AC1, X5.2
28DC: B2.+, C4.+, C6.2, D2.C, U2.3 (IN)
+2.5V: C17.2, U4.5 (OUTS), U4.6 (OUTF), U15.29 (PE[4]/AREF)
+3.3V: C23.+, C26.1, C28.1, R35.1, R44.2, U5.5 (OUT), U7.4 (VCC), U16.1 (VCCA), U16.12 (OE), U17.3 (VCCA), U17.6 (OE), X12.5
+5V: C5.+, C22.+, C27.1, C30.1, D4.C, D5.C, K1.1, K2.1, L5.2, L6.2, R24.1, R25.2, R26.1, R27.2, R28.2, R29.2, R30.2, R31.2, R32.2, R39.1, U1.4 (FB), U3.1 (VIN), U3.6 (!SHDN), U4.3 (EN), U4.4 (IN), U5.1 (IN), U5.3 (EN), U8.4 (V+), U9.8 (V+), U10.1 (A), U12.2 (+VDC), U13.5 (VCC), U14.5 (VCC), U15.5 (VCC), U16.11 (VCCB), U17.7 (VCCB), X6.1, X11.2, Y1.4 (VDD)
+12.5V: C19.1, U6.1 (VOUT), X12.23
+28V: C10.+, C11.+, C18.1, D2.A, D3.C, Q4.2 (C), R7.2, R16.2, R17.2, R18.2, U1.2 (VIN), U2.2 (OUT), U6.6 (VIN), U11.9 (VDD)
-5V: C25.+, R40.2, U3.2 (VOUT), U8.11 (V-), U9.4 (V-)
FAN: C13.1, C14.+, Q4.3 (E), R10.1, R12.1, X10.6
GND: B2.-, C4.-, C5.-, C6.1, C8.2, C9.-, C10.-, C11.-, C13.2, C14.-, C15.2, C16.-, C17.1, C18.2, C19.2, C20.-, C22.-, C23.-, C25.-, C26.2, C27.2, C28.2, C29.1, C30.2, CF1.3, CF2.3, CF3.3, D1.A, HS3.A2,2, HS3.B2,2, K1.S2 (S), K2.O2 (O), Q1.2 (S), Q2.2 (S), Q6.E, Q7.2 (S), R9.1, R11.2, R13.2, R21.2, R23.2, R34.2, R38.2, R43.1, R47.1, U1.1 (SHDN), U1.5 (GND), U1.6 (GND-1), U1.7 (GND-2), U1.8 (GND-3), U3.5 (GND), U4.1 (GNDF), U4.2 (GNDS), U5.2 (GND), U5.4 (NC), U6.2 (GND1), U6.4 (NC), U6.5 (GND2), U7.1 (GND), U9.1 (GND), U11.3 (VSS), U11.4 (DGND), U12.3 (GND), U12.6 (MODE), U13.2 (GND), U14.2 (GND), U15.6 (GND-1), U15.28 (GND), U16.6 (GND), U17.2 (GND), X4.1, X4.2, X7.2, X8.2, X9.2, X11.6, X12.1, X12.2, X12.3, X12.7, X12.8, X12.10, X12.11, X12.12, X12.16, X12.17, X12.18, X12.19, X12.20, X12.24, Y1.2 (GND), Z1.A
HOUT: C3.1, Q3.T2 (A2), R3.1, R4.1, R6.1, X3.1
L: C1.2, K1.P1, K1.S1 (S), R1.2, R45.2, X1.2
unnamed: Q4.1 (B), Q5.C, Q5.C@1 (C), Q6.C, Q6.C@1 (C), R16.1
unnamed: R45.1, X2.2
unnamed: R14.1, U8.12 (+IN)
unnamed: C1.1, R2.2
unnamed: C2.1, R3.2
unnamed: R6.2, U10.6 (A2)
unnamed: U17.4 (A2), X12.14, X12.15
unnamed: Q3.G, R5.1, U10.4 (A1)
unnamed: U7.7 (SO), U16.3 (A2)
unnamed: U7.5 (SCK), U16.2 (A1)
unnamed: U17.5 (A1), X12.13
unnamed: U7.6 (!CS), U16.4 (A3)
unnamed: U15.44 (PB[4]/PCINT12/Y28/OC0B/!SS0), U16.8 (B3)
unnamed: C8.1, Q5.B, U11.10 (W)
unnamed: R11.1, U11.2 (B)
unnamed: D4.A, K1.2, Q1.3 (D)
unnamed: C9.+, D3.A, R7.1, R8.2, U2.1 (ADJ)
unnamed: R8.1, R9.2
unnamed: D5.A, K2.2, Q2.3 (D)
unnamed: R10.2, U11.1 (A)
unnamed: D1.K (C), L6.1, U1.3 (SW)
unnamed: Q5.E, R17.1, Z1.C
unnamed: L1.8 (3), X10.1
unnamed: Q6.B, R15.1
unnamed: L1.1, X10.2
unnamed: R36.2, U16.10 (B1)
unnamed: R37.2, U16.9 (B2)
unnamed: U6.3 (ON/!OFF), U15.41 (PB[1]/PCINT9/Y25/CLKO/T1)
unnamed: R34.1, X12.21
unnamed: R12.2, R13.1, U8.3 (+IN)
unnamed: U9.5 (ON), U9.6 (ON/STR)
unnamed: C15.1, R14.2, U8.1 (OUT), U8.2 (-IN)
unnamed: U8.13 (-IN), U8.14 (OUT), U15.37 (PA[0]/PCINT0/ADC0/Y0/)
unnamed: R19.1, U10.2 (C)
unnamed: C20.+, C21.1, R18.1, X10.5
unnamed: R19.2, U15.35 (PA[2]/PCINT2/ADC2/Y2/)
unnamed: C21.2, R39.2, R40.1, U8.5 (+IN)
unnamed: R20.1, U8.7 (OUT), U9.3 (-IN)
unnamed: R22.1, R24.2, U8.10 (+IN), U9.7 (OUT)
unnamed: R20.2, R21.1, U8.6 (-IN)
unnamed: R22.2, R23.1, U9.2 (+IN)
unnamed: U8.8 (OUT), U8.9 (-IN), U15.22 (PC[3]/PCINT19/X13/Y21/ICP4/TMS)
unnamed: U11.5 (!CS), U15.15 (PD[6]/PCINT30/X6/Y14/OC2B/ICP1/!SS1)
unnamed: U11.6 (CLK), U15.16 (PD[7]/PCINT31/X7/Y15/OC2A/XCK2/SCK1)
unnamed: U11.7 (SDI), U15.18 (PE[3]/X9/Y17/TXD2/MOSI1)
unnamed: U11.8 (SDO), U15.17 (PE[2]/X8/Y16/RXD2/MISO1)
unnamed: Q2.1 (G), U15.20 (PC[1]/PCINT17/X11/Y19/SDA0)
unnamed: K1.O2 (O), R25.1
unnamed: Q1.1 (G), U15.21 (PC[2]/PCINT18/X12/Y20/T4/TCK)
unnamed: R15.2, U15.23 (PC[4]/PCINT20/X14/Y22/OC4A/TDO)
unnamed: K2.S2 (S), R26.2
unnamed: K2.P2, U15.33 (PA[4]/PCINT4/ADC4/Y4)
unnamed: K1.P2, U15.32 (PA[5]/PCINT5/ADC5/Y5)
unnamed: Q7.3 (D), X6.2
unnamed: Q7.1 (G), U15.36 (PA[1]/PCINT1/ADC1/Y1/)
unnamed: R29.1, U13.3 (IN2), X7.4
unnamed: R28.1, U12.4 (AIN), X7.3
unnamed: R31.1, U14.3 (IN2), X8.1
unnamed: R27.1, U12.5 (BIN), X7.1
unnamed: R30.1, U14.1 (IN1), X9.1
unnamed: C16.+, X12.22
unnamed: C24.+, U3.3 (C+)
unnamed: R32.1, U13.1 (IN1), X10.4
unnamed: C24.-, U3.4 (C-)
unnamed: R33.1, X10.3
unnamed: R37.1, U15.2 (PB[6]/PCINT14/Y30/OC3A/MISO0), X11.1
unnamed: R35.2, X12.6
unnamed: R33.2, U15.34 (PA[3]/PCINT3/ADC3/Y3)
unnamed: U12.8 (!UPCLK), U15.11 (PD[2]/INT0/PCINT26/X2/Y10/RXD1)
unnamed: U12.7 (!DNCLK), U15.12 (PD[3]/INT1/PCINT27/X3/Y11/TXD1)
unnamed: U13.6 (OUT1), U15.30 (PA[7]/PCINT7/ADC7/Y7)
unnamed: U13.4 (OUT2), U15.40 (PB[0]/PCINT8/Y24/T0/XCK0)
unnamed: U14.4 (OUT2), U15.19 (PC[0]/PCINT16/X10/Y18/SCL0)
unnamed: U14.6 (OUT1), U15.9 (PD[0]/PCINT24/X0/Y8/T3/RXD0)
unnamed: CF1.2, CF2.2, CF3.2, R42.2, U7.3 (T+)
unnamed: U15.8 (PE[1]/PCINT33/XTAL1), Y1.3 (OUTPUT)
unnamed: CF1.1, CF2.1, CF3.1, R41.2, U7.2 (T-)
unnamed: R36.1, U15.3 (PB[7]/PCINT15/Y31/OC3B/OC4B/SCK0), X11.3
unnamed: U15.1 (PB[5]/PCINT13/Y29/ICP3/MOSI0), X11.4
unnamed: U15.4 (!RESET), X11.5
unnamed: R38.1, U12.1 (RBIAS)
unnamed: L1.5 (4), L2.4
unnamed: L1.4 (2), L2.1
unnamed: L2.3, L3.2
unnamed: L2.2, L4.2
unnamed: L3.1, R41.1, R43.2
unnamed: L4.1, R42.1, R44.1
unnamed: C29.2, L5.1, U15.27 (AVCC)
unnamed: C3.2, R1.1, R2.1, R4.2, X1.1, X2.1, X3.2
RESET-I2C: R46.1, U15.7 (PE[0]/PCINT32/XTAL2)
RESET-I2C-3.3: R46.2, R47.2, X12.9
SCL-I2C: U15.39 (PE[6]/SCL1), U17.8 (B1)
SDA-I2C: U15.38 (PE[5]/SDA1), U17.1 (B2)
SL1: K1.O1 (O), K2.O1 (O), K2.P1
SL2: C2.2, K2.S1 (S), Q3.T1 (A1), R5.2

Notes on the sheet:
Transformer Primary
Mains
Heater
Earth/Ground
Buzzer
Encoder
Down
Fan
Tach
Switch
LED
Transformer Secondary
Midas OLED Display MCOT128064BY-WM
ICSP

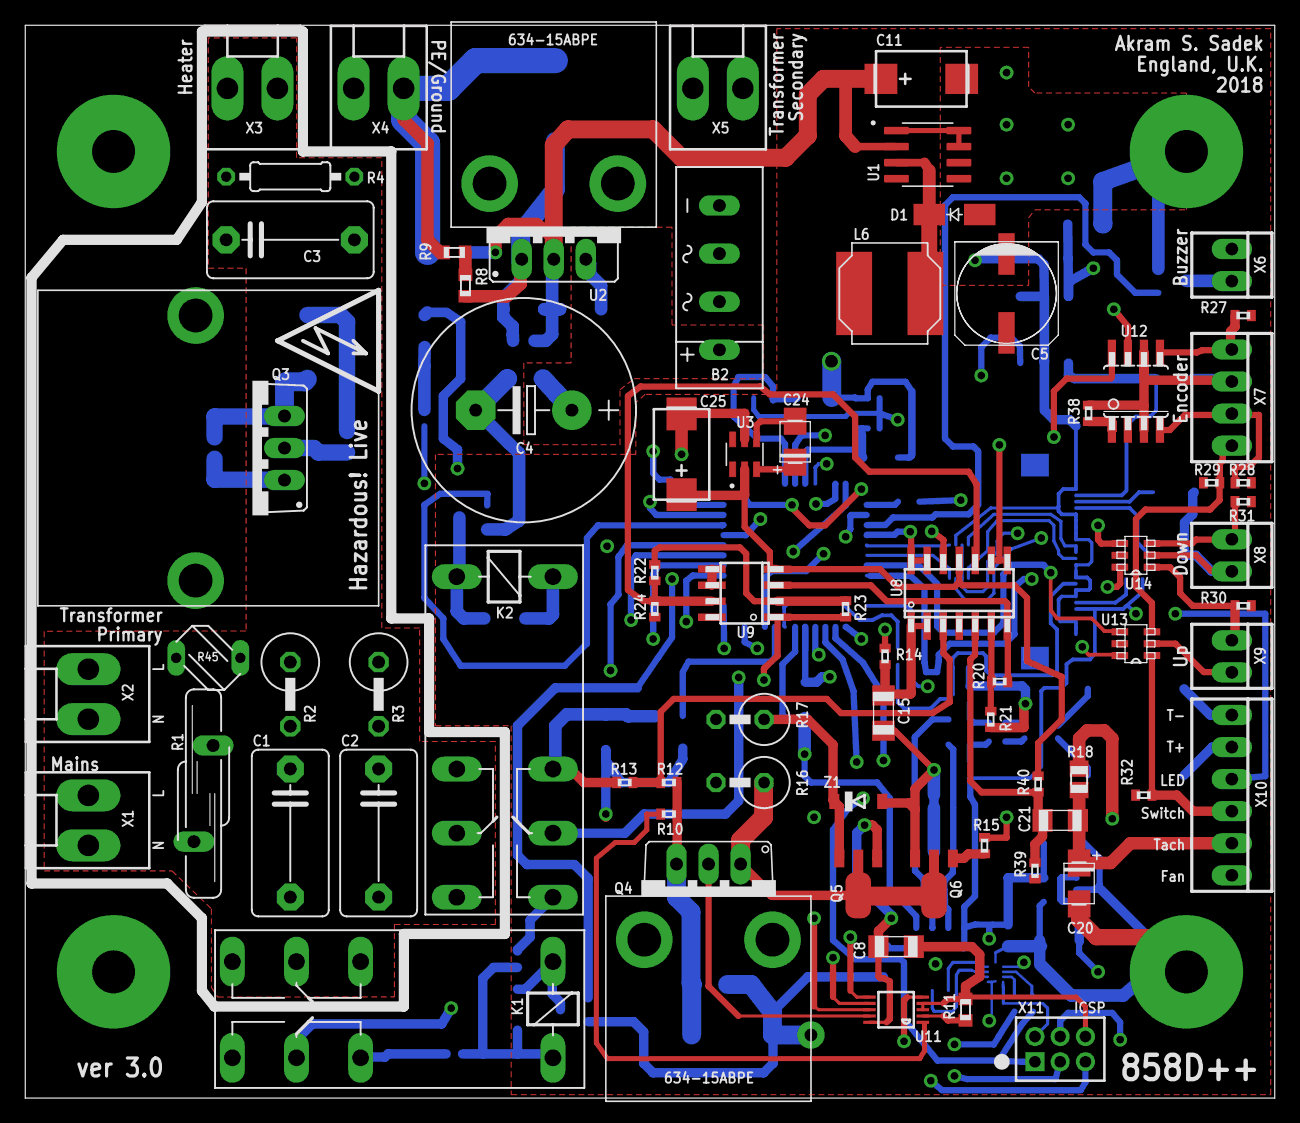
[picture p8: board 858D_v3.brd from above]

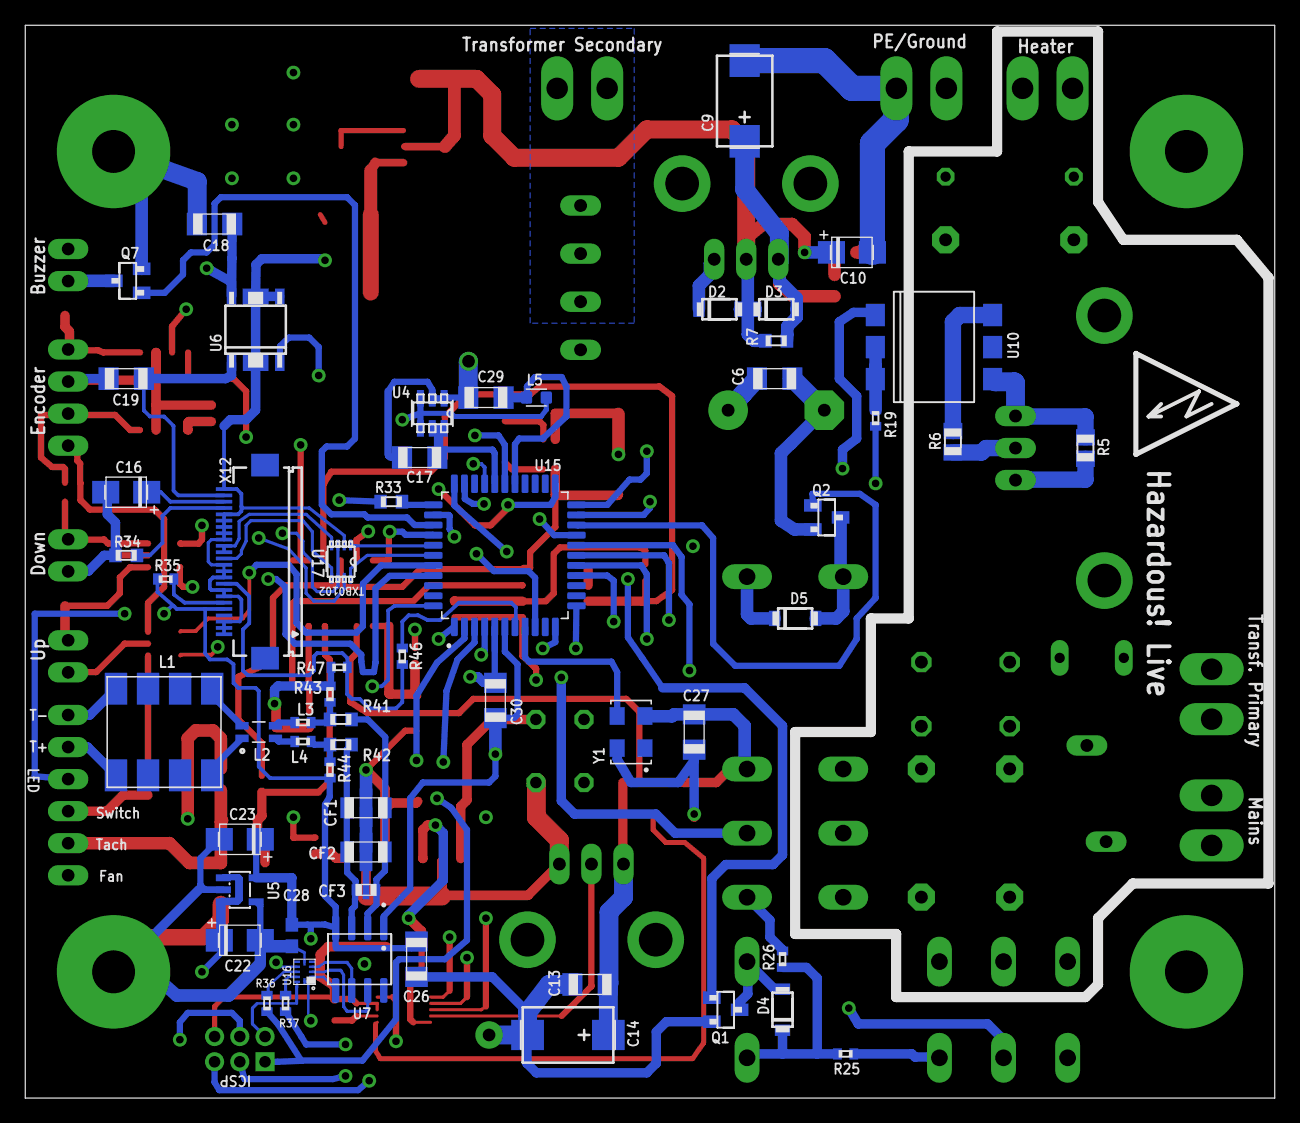
[picture p9: board 858D_v3.brd from below]

Board: 4 copper layers, 99.0 x 85.0 mm, 133 parts (58 on the bottom side), 108 nets.
