zchap40/858D-/(notices)

Notices in the files:
parts and their libraries:
con-molex-milli-grid: Copyright (C) 2010, Bob Starr
